PlasmaMedicineLifeSciences/Prototype-Run-3/(list of files, drawings)

Other design files:
GOWANDA/Miscellaneous Devices/Miscellaneous Devices.PcbLib
GOWANDA/Miscellaneous Devices/Miscellaneous Devices.SchLib
GOWANDA/ON Semi Zener Diodes.PcbLib
GOWANDA/UCC28180 PFC-V02-GOWANDA.PrjPcb
GOWANDA/UCC28180-2-V02 - GOWANDA.SchDoc
GOWANDA/UCC28180-3-V02-GOWANDA.SchDoc
GOWANDA/UCC28180-V02-GOWANDA.PcbDoc
GOWANDA/UCC28180-V02.PcbLib
GOWANDA/ucc28180-V02.SchLib
GOWANDA/UCC 28180-1-V02 -GOWANDA.SchDoc
UCC28180-V02-XFMRS.PcbDoc
UCC 28180 PFC-V02-XMFRS.PrjPcb
USMIlogo.PcbDoc
XFRMS/Miscellaneous Devices/Miscellaneous Devices.PcbLib
XFRMS/Miscellaneous Devices/Miscellaneous Devices.SchLib
XFRMS/ON Semi Zener Diodes.PcbLib
XFRMS/UCC28180-2-V02.SchDoc
XFRMS/UCC28180-3-V02.SchDoc
XFRMS/UCC28180-V02.PcbDoc
XFRMS/UCC28180-V02.PcbLib
XFRMS/ucc28180-V02.SchLib
XFRMS/UCC 28180 PFC-V02.PrjPcb
XFRMS/UCC 28180-1-V02.SchDoc
